jojo1193/Kicad-Library/README.md

# Kicad-Library
Own Kicad Library with different parts of different projects.
