jojo1193/Kicad-Library/Antenna/3d/ANT-433-USP410.step

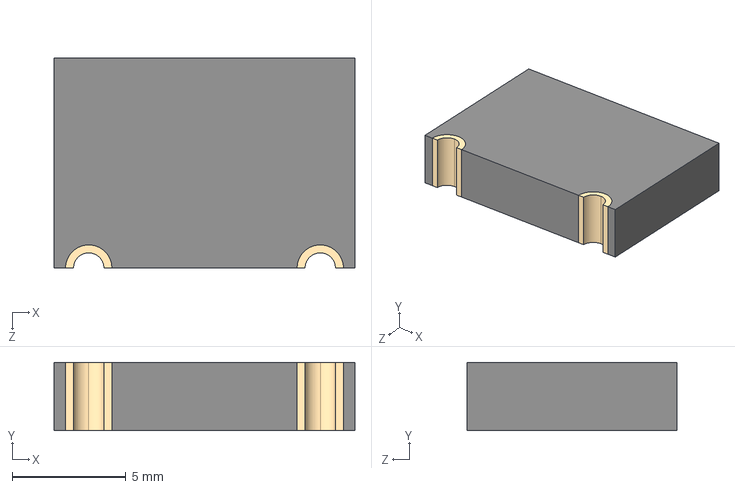
[picture p1: CAD file, 2024-01-16]
Antenna/3d/ANT-433-USP410.step
13.2 x 3.00 x 9.22 mm
