jojo1193/Kicad-Library/Caps/3d/AY1152M41Y5UC63L0.stp

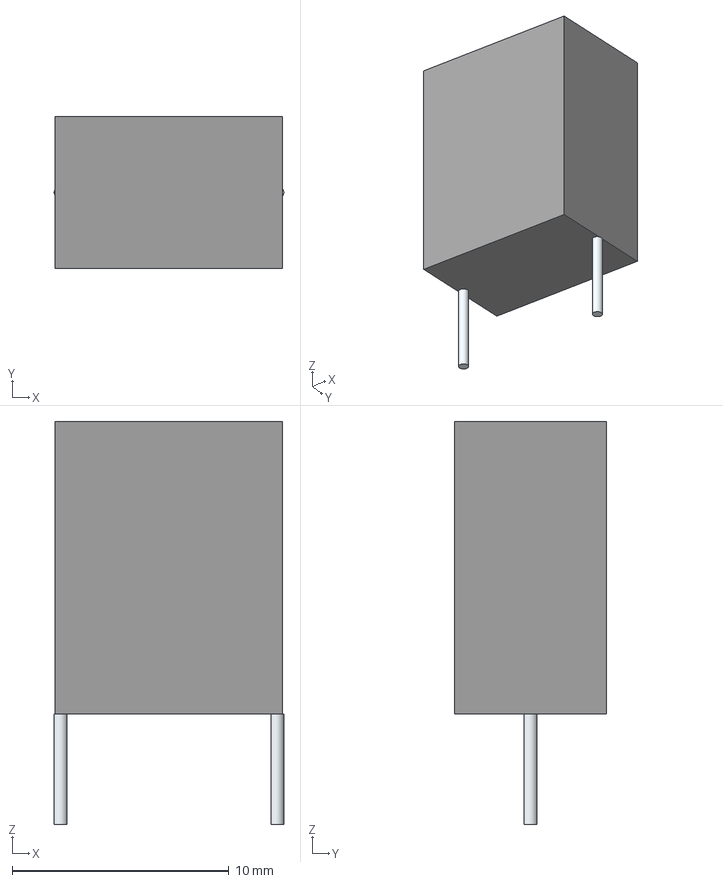
[picture p2: CAD file, 2024-01-16]
Caps/3d/AY1152M41Y5UC63L0.stp
10.6 x 7.00 x 18.6 mm
Leads
