jojo1193/Kicad-Library/Comparator/3d/TLV1811LDBVR.stp

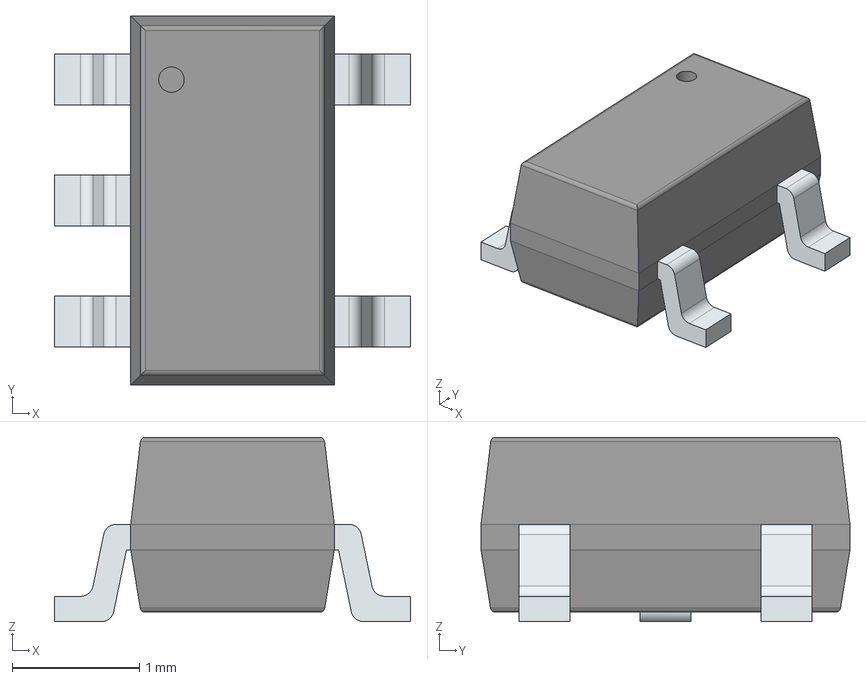
[picture p3: CAD file, 2024-11-26]
Comparator/3d/TLV1811LDBVR.stp
2.80 x 2.90 x 1.45 mm
PinsArrayL
PinsArrayR
