jojo1193/Kicad-Library/Connectors/3d/LD15S33E4GX00LF.stp

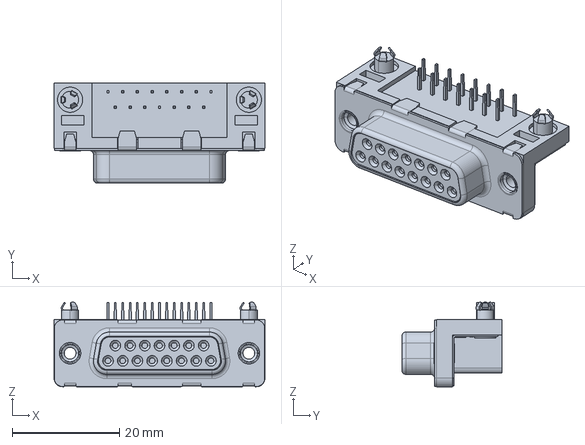
[picture p4: CAD file, 2024-11-26]
Connectors/3d/LD15S33E4GX00LF.stp
39.3 x 18.7 x 15.8 mm
