jojo1193/Kicad-Library/Crystal/3d/ECS-160-10-36-CKM-TR3.stp

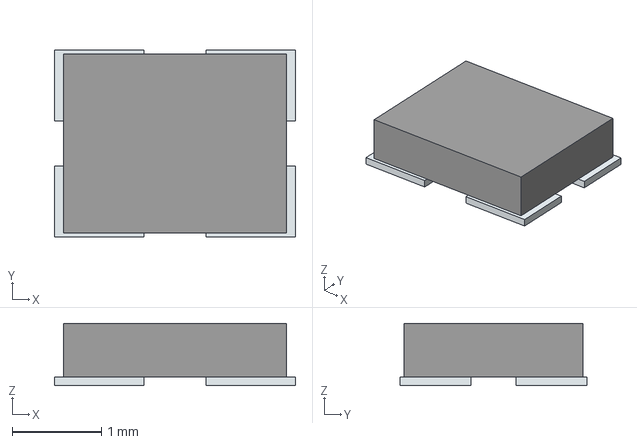
[picture p5: CAD file, 2024-01-16]
Crystal/3d/ECS-160-10-36-CKM-TR3.stp
2.70 x 2.10 x 0.7 mm
Pins
