jojo1193/Kicad-Library/Devices/3d/RX470C-V1 v6.step

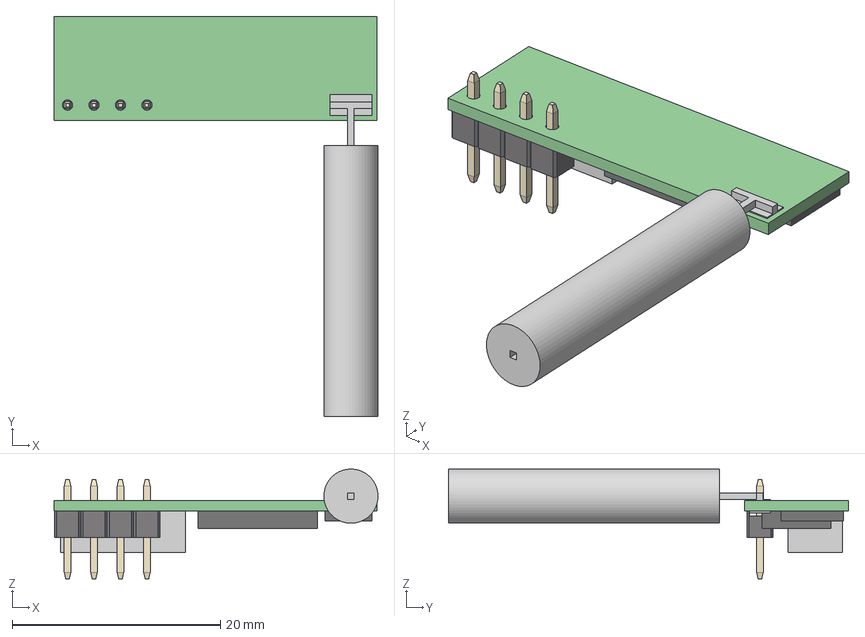
[picture p6: CAD file, 2024-01-16]
Devices/3d/RX470C-V1 v6.step
31.1 x 38.4 x 10.5 mm
BG030-04-A-0400-0300-N-G_P x 4
BG030-04-A-0400-0300-N-G_H
Platine
BauteilePlatine
Antenne
