jojo1193/Kicad-Library/Diode/3d/SL05.TCT.stp

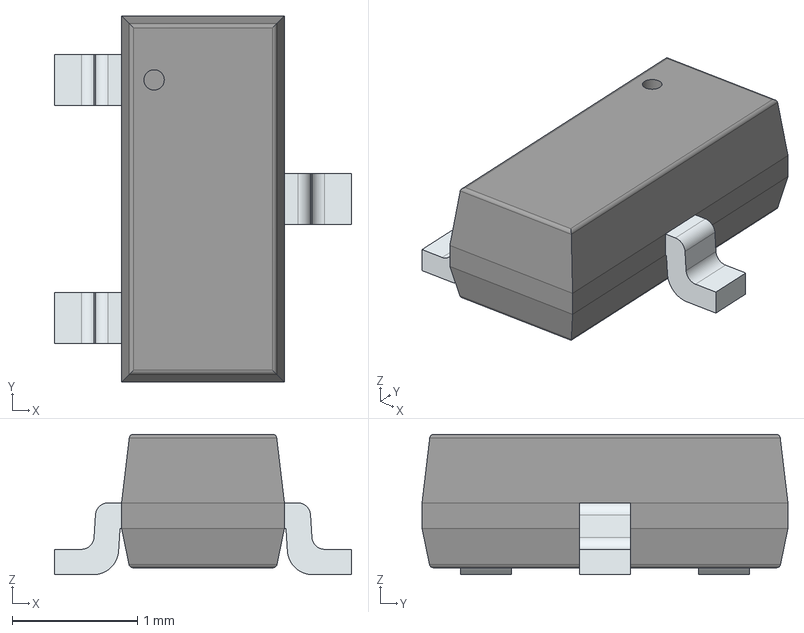
[picture p7: CAD file, 2024-11-26]
Diode/3d/SL05.TCT.stp
2.37 x 2.92 x 1.12 mm
PinsArrayL
FilletPinR
