jojo1193/Kicad-Library/IC/3d/AD587JRZ.stp

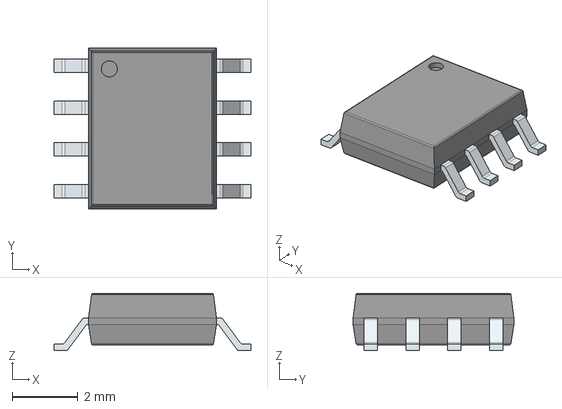
[picture p8: CAD file, 2024-01-16]
IC/3d/AD587JRZ.stp
6.00 x 4.90 x 1.75 mm
PinsArrayLR
