jojo1193/Kicad-Library/Inductors/3d/SSRH24NVS-35080.step

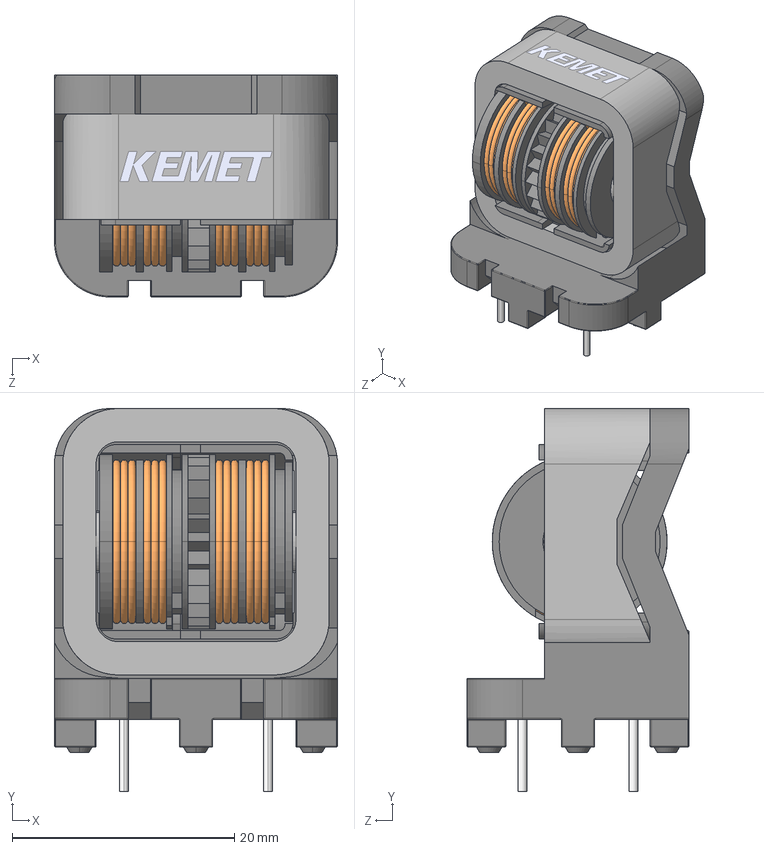
[picture p9: CAD file, 2024-11-29]
Inductors/3d/SSRH24NVS-35080.step
25.5 x 34.5 x 20.0 mm
