jojo1193/Kicad-Library/Logic/3d/NC7SZ32P5X-F22057.stp

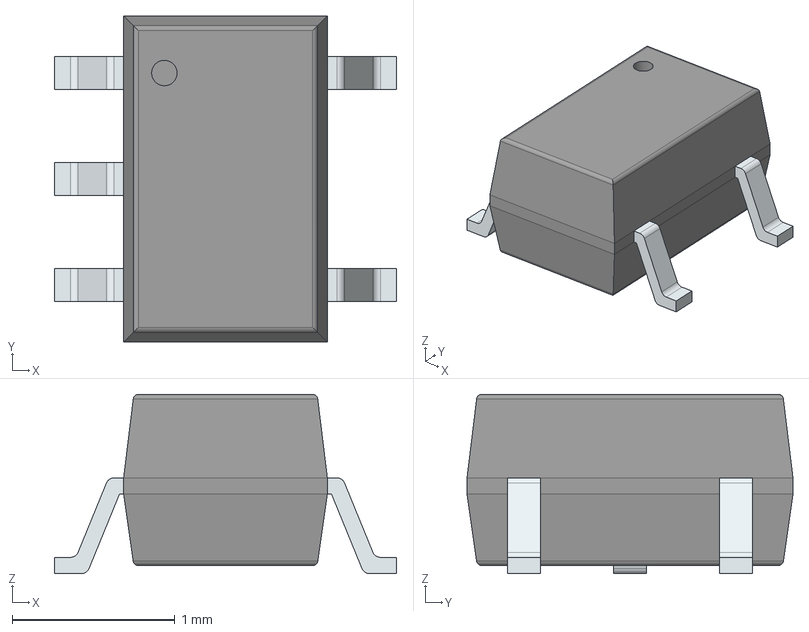
[picture p10: CAD file, 2024-01-16]
Logic/3d/NC7SZ32P5X-F22057.stp
2.10 x 2.00 x 1.10 mm
PinsArrayL
PinsArrayR
