jojo1193/Kicad-Library/Microcontroller/3d/STM32G030K6T6.stp

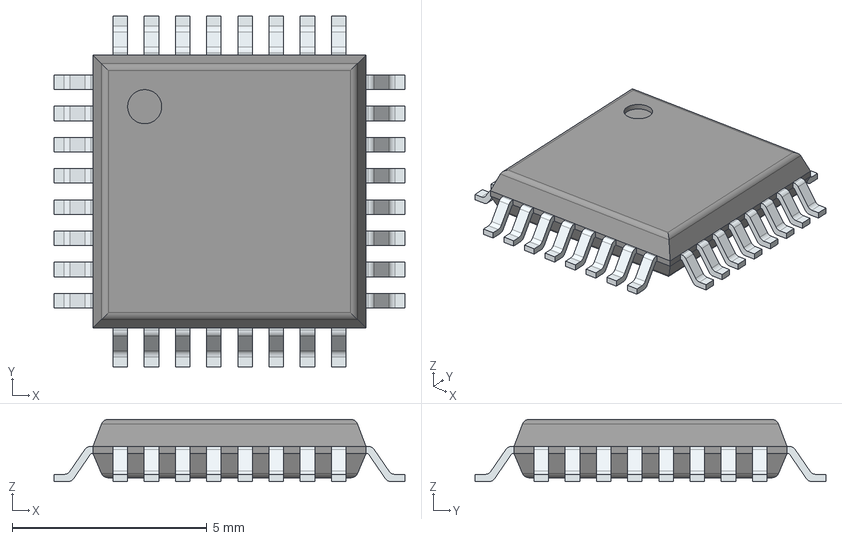
[picture p11: CAD file, 2024-03-09]
Microcontroller/3d/STM32G030K6T6.stp
9.00 x 9.00 x 1.60 mm
PinsArrayLR
PinsArrayTB
