jojo1193/Kicad-Library/MOSFET/3d/SSM3J132TU,LF.stp

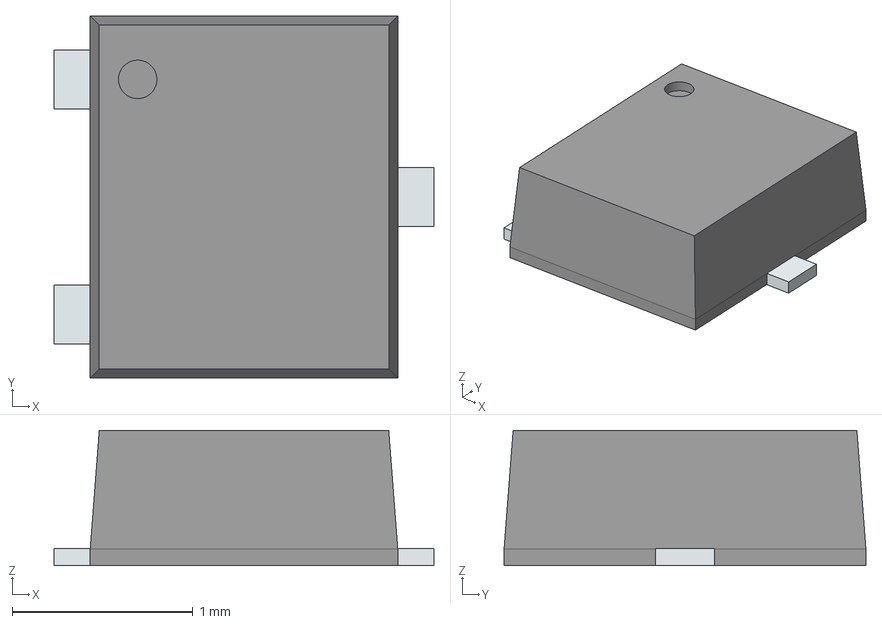
[picture p12: CAD file, 2024-07-02]
MOSFET/3d/SSM3J132TU,LF.stp
2.10 x 2.00 x 0.748 mm
PinsArrayL
PinsArrayR
