jojo1193/Kicad-Library/OpAmps/3d/NCV321SN3T1G.stp

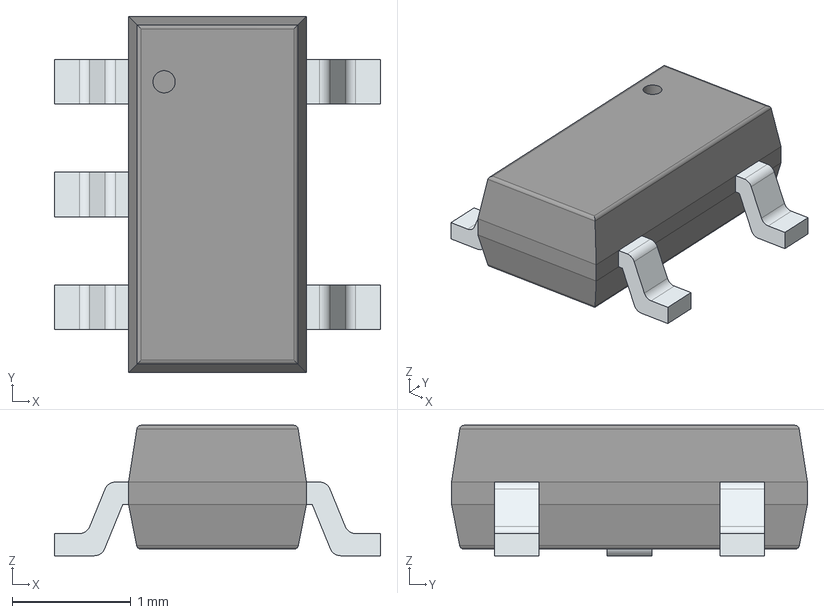
[picture p13: CAD file, 2024-01-16]
OpAmps/3d/NCV321SN3T1G.stp
2.75 x 3.00 x 1.10 mm
PinsArrayL
PinsArrayR
