jojo1193/Kicad-Library/Optocoupler/3d/OPI1280-032.STEP

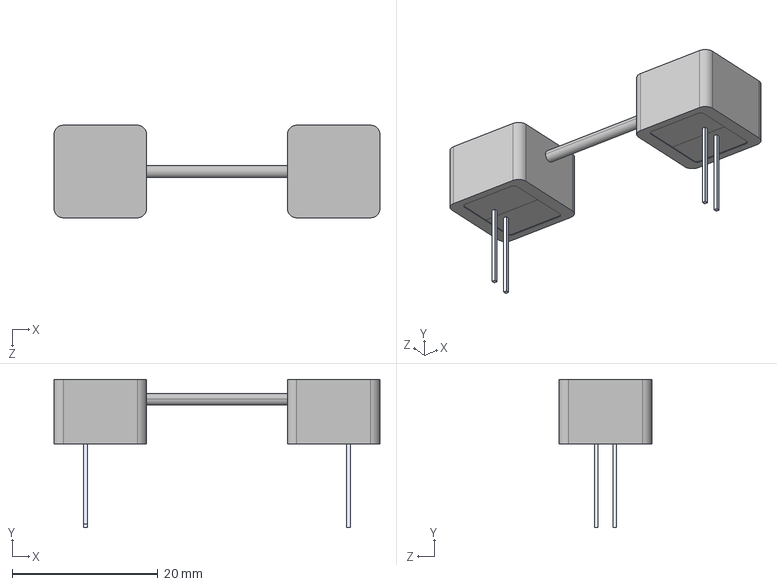
[picture p14: CAD file, 2024-01-16]
Optocoupler/3d/OPI1280-032.STEP
44.7 x 20.3 x 12.7 mm
