jojo1193/Kicad-Library/Regulators/3d/NCP1117ST50T3G.stp

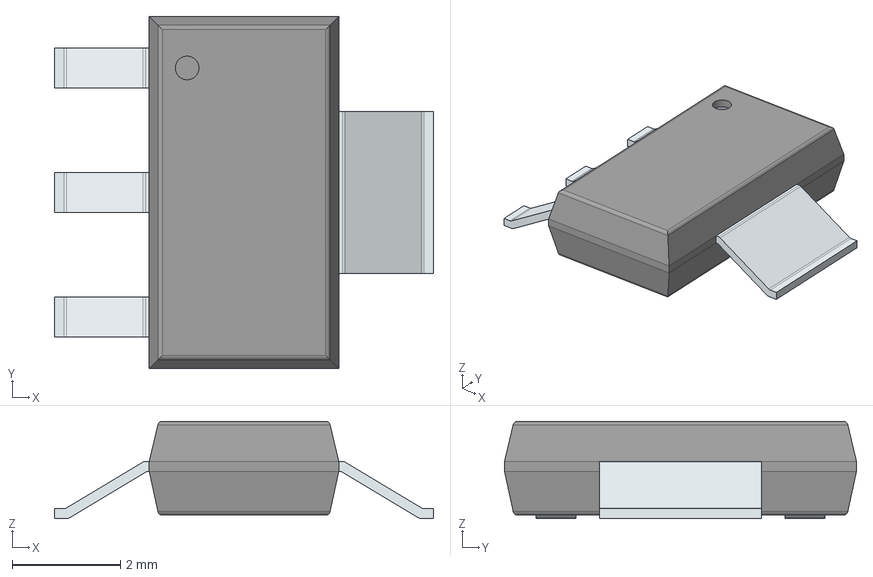
[picture p15: CAD file, 2024-01-16]
Regulators/3d/NCP1117ST50T3G.stp
7.00 x 6.50 x 1.80 mm
PinsArrayL
FilletPinR
