jojo1193/Kicad-Library/Resistor/3d/TC33X-2-103E.stp

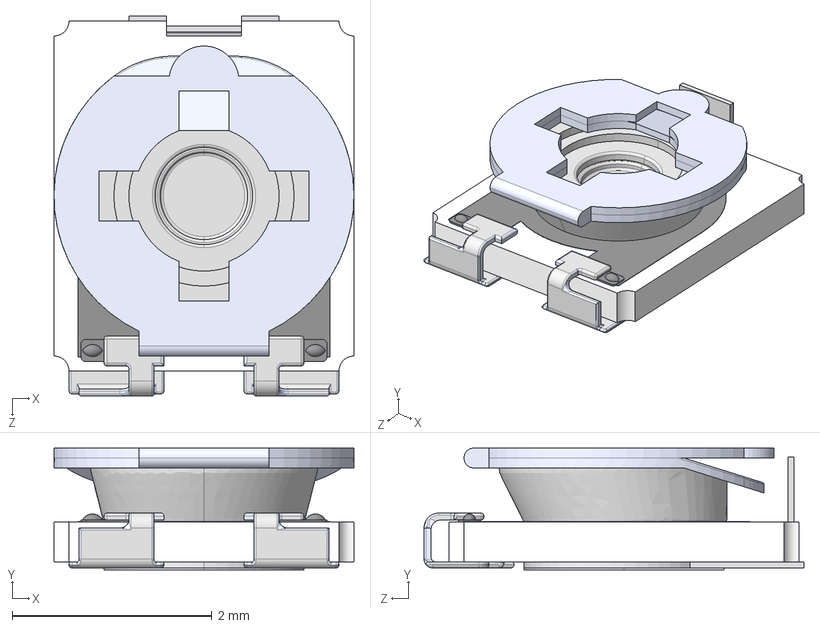
[picture p16: CAD file, 2024-01-16]
Resistor/3d/TC33X-2-103E.stp
3.00 x 1.22 x 3.80 mm
