jojo1193/Kicad-Library/Switch/3d/4-1825136-5.stp

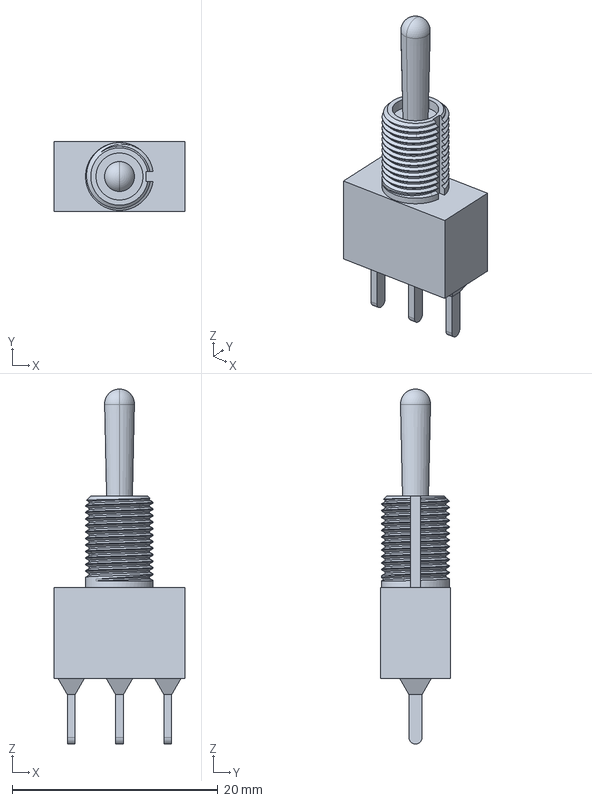
[picture p17: CAD file, 2024-11-29]
Switch/3d/4-1825136-5.stp
12.7 x 6.86 x 34.5 mm
