jojo1193/Kicad-Library/Testpoints/3d/Keystone Compact/Keystone-5005-Red.STEP

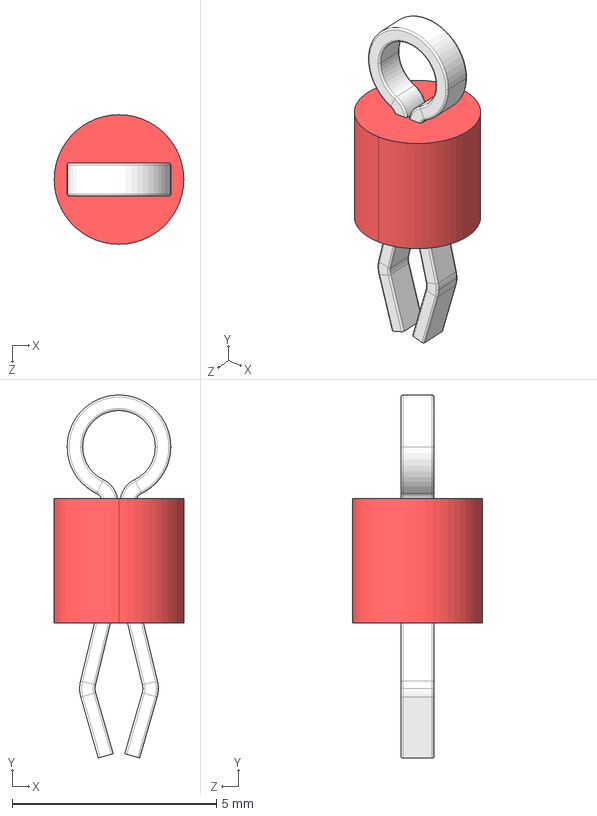
[picture p18: CAD file, 2024-11-26]
Testpoints/3d/Keystone Compact/Keystone-5005-Red.STEP
3.17 x 8.89 x 3.17 mm
