jojo1193/Kicad-Library/Testpoints/3d/Keystone Multipurpose/Keystone-PN5127-Blue.STEP

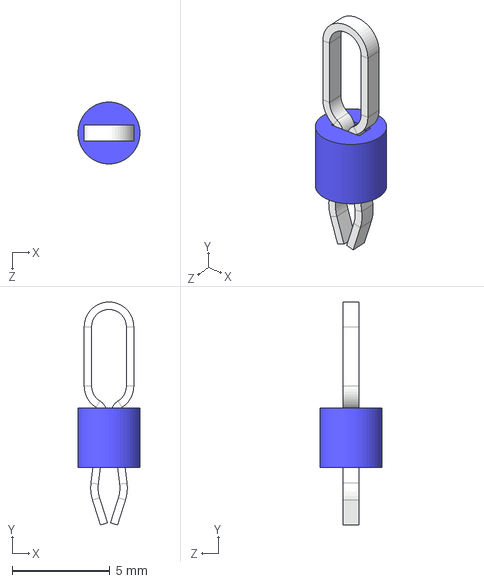
[picture p20: CAD file, 2024-11-26]
Testpoints/3d/Keystone Multipurpose/Keystone-PN5127-Blue.STEP
3.17 x 11.4 x 3.17 mm
