jojo1193/Kicad-Library/Wireless&HF_ICs/3d/CC113LRGPR.stp

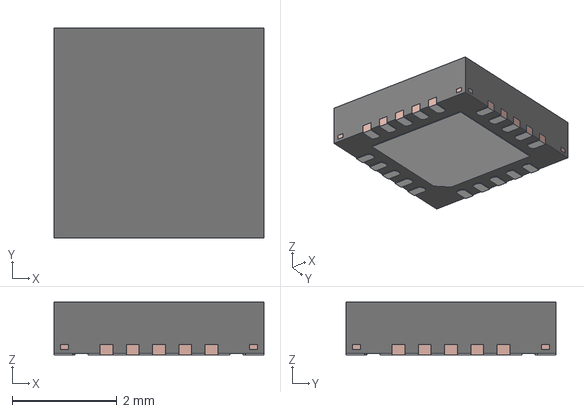
[picture p21: CAD file, 2024-07-02]
Wireless&HF_ICs/3d/CC113LRGPR.stp
4.00 x 4.00 x 1.00 mm
FRAME
