jojo1193/Kicad-Library/Caps/3d/CP_D8mmH12.2mm.stp

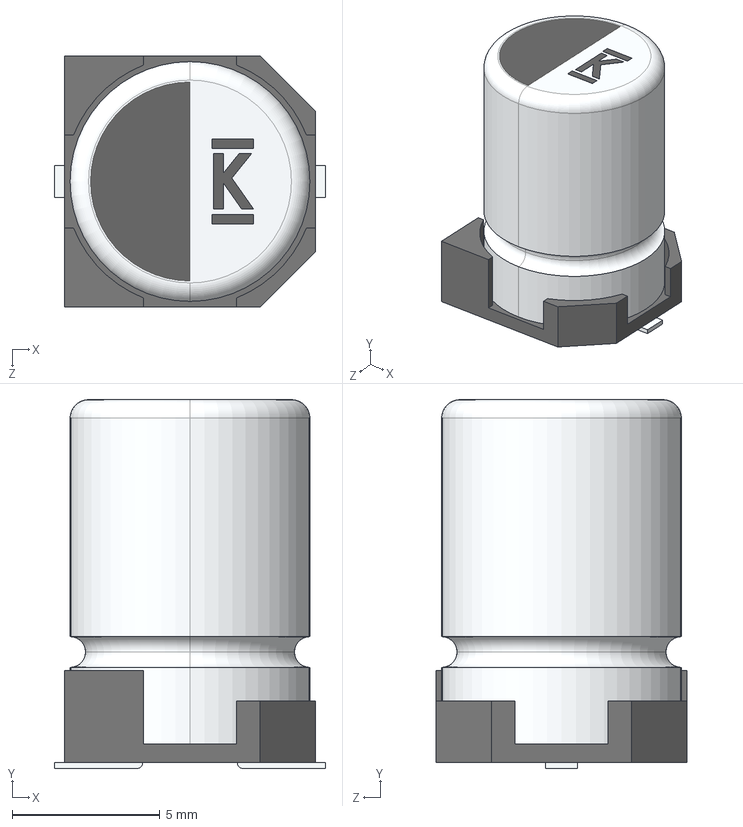
[picture p22: CAD file, 2024-01-16]
Caps/3d/CP_D8mmH12.2mm.stp
9.20 x 12.5 x 8.50 mm
