jojo1193/Kicad-Library/Connectors/3d/MicroUSB.stp

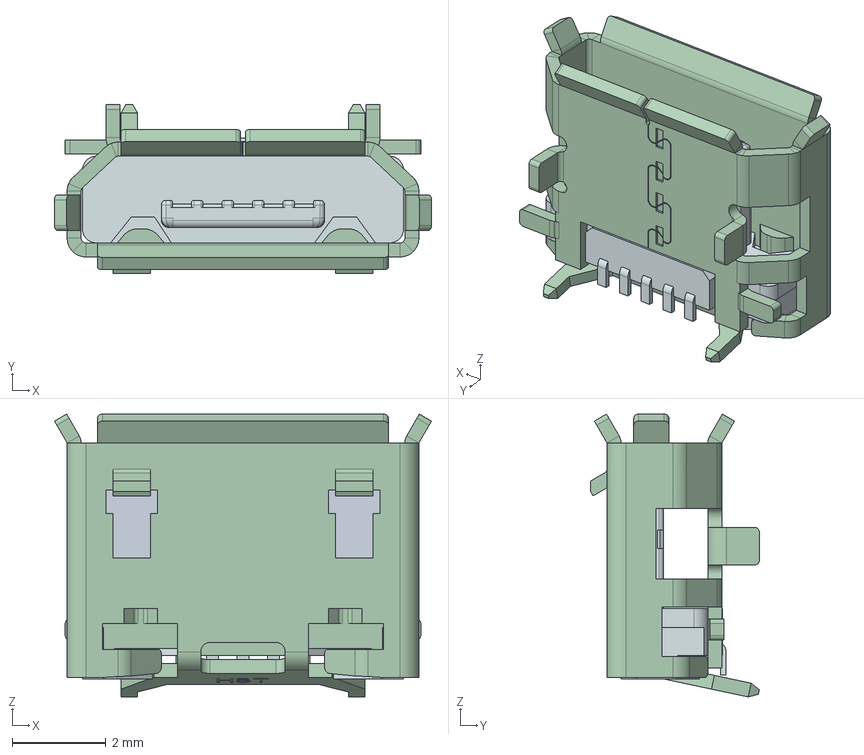
[picture p23: CAD file, 2024-07-02]
Connectors/3d/MicroUSB.stp
8.04 x 3.60 x 6.03 mm
