jojo1193/Kicad-Library/DCDCconverter/3d/AE15-EW-S12.stp

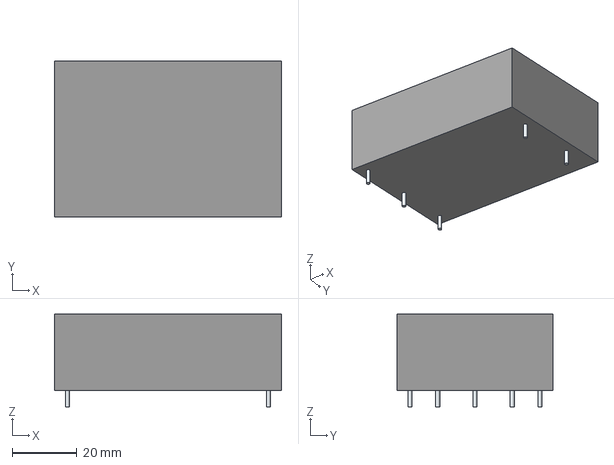
[picture p24: CAD file, 2024-01-16]
DCDCconverter/3d/AE15-EW-S12.stp
70.0 x 48.0 x 28.6 mm
Leads
