jojo1193/Kicad-Library/Inductors/3d/FBMH2016HM121NT.stp

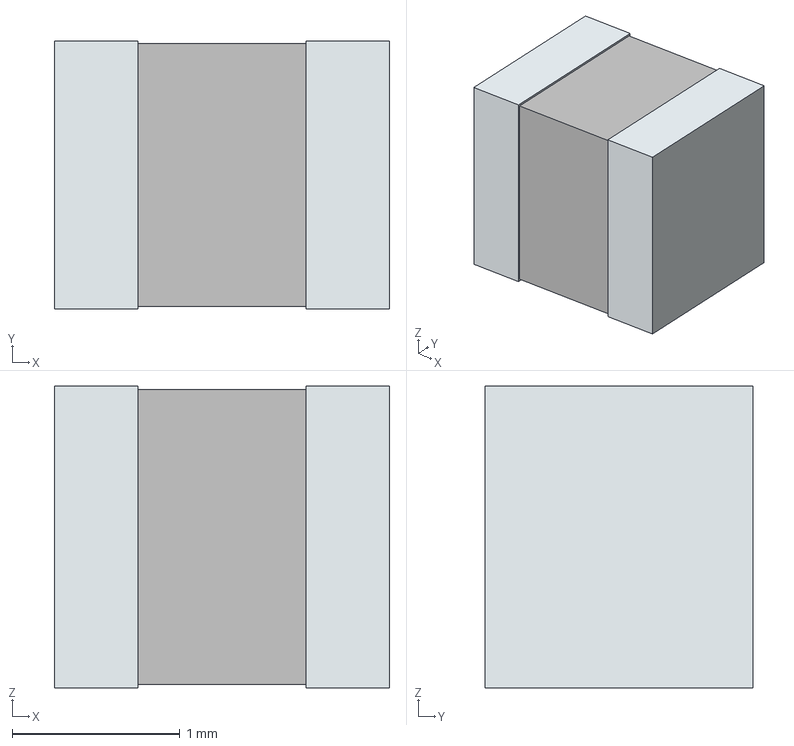
[picture p25: CAD file, 2024-07-02]
Inductors/3d/FBMH2016HM121NT.stp
2.00 x 1.60 x 1.80 mm
term1
term2
