jojo1193/Kicad-Library/OpAmps/3d/TS372CDT.stp

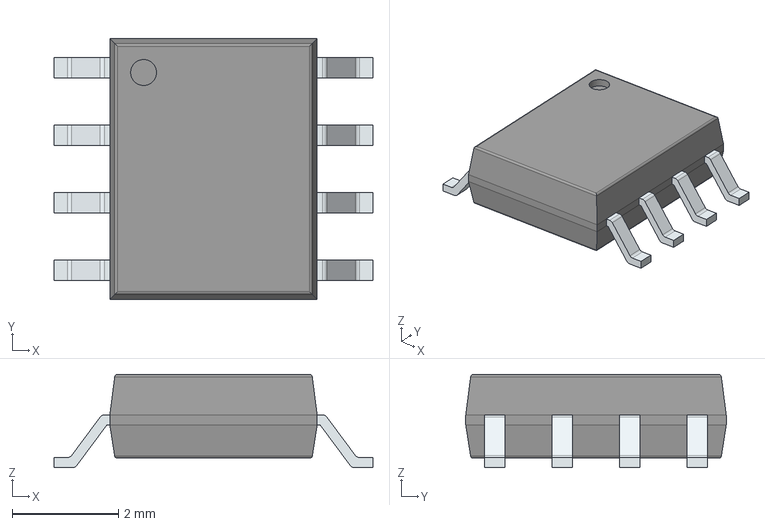
[picture p26: CAD file, 2024-01-16]
OpAmps/3d/TS372CDT.stp
6.00 x 4.90 x 1.75 mm
PinsArrayLR
