jojo1193/Kicad-Library/Regulators/3d/BAJ2CC0FP-E2.stp

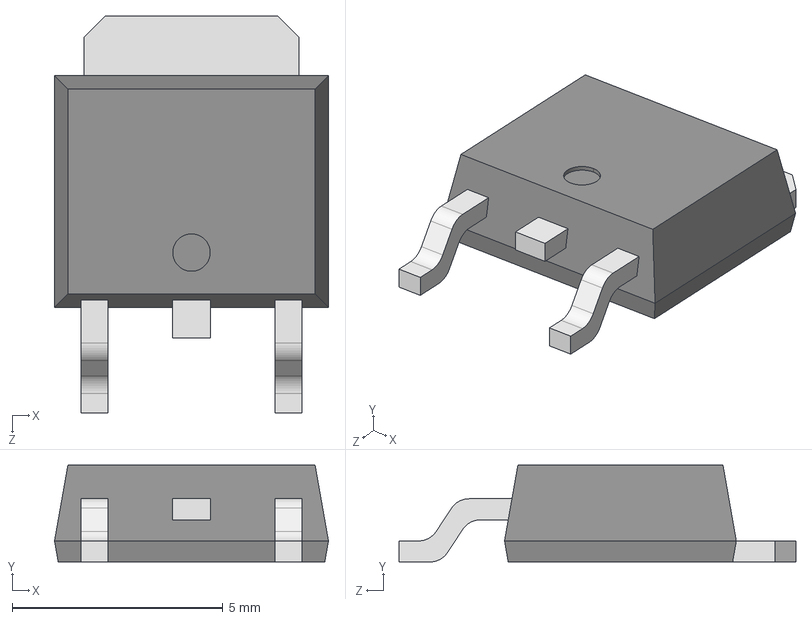
[picture p27: CAD file, 2024-01-16]
Regulators/3d/BAJ2CC0FP-E2.stp
6.50 x 2.30 x 9.41 mm
