jojo1193/Kicad-Library/Switch/3d/09.03290.01.stp

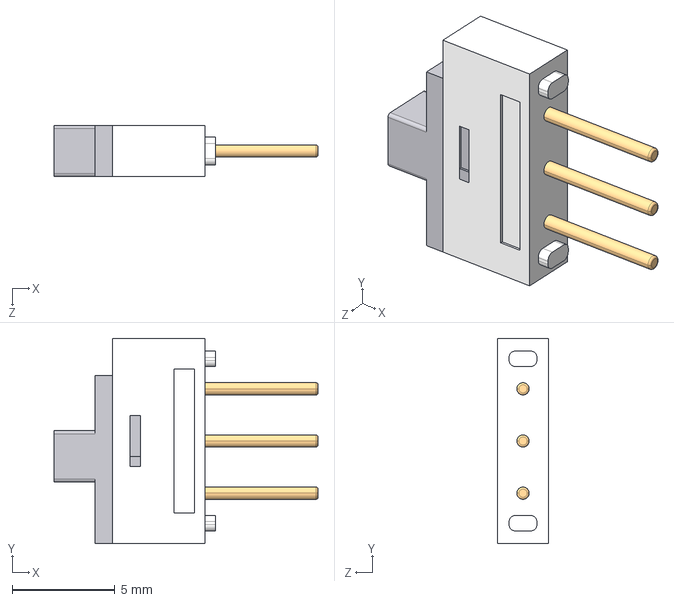
[picture p28: CAD file, 2024-11-26]
Switch/3d/09.03290.01.stp
12.8 x 10.0 x 2.50 mm
