jojo1193/Kicad-Library/Testpoints/3d/Keystone Compact/Keystone-5121-Green.STEP

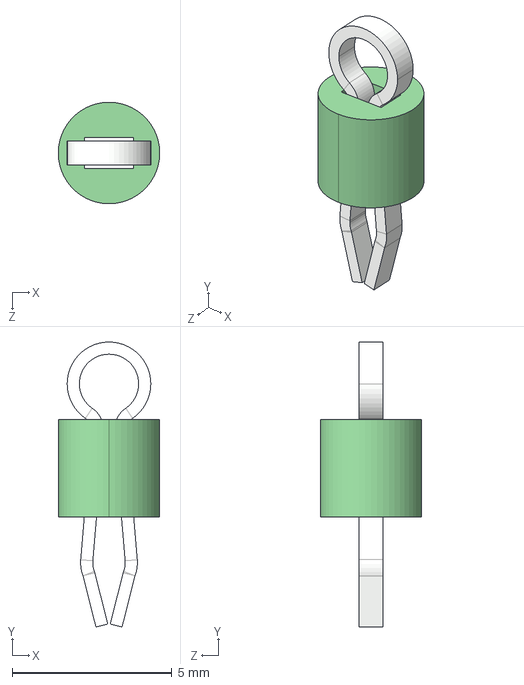
[picture p29: CAD file, 2024-11-26]
Testpoints/3d/Keystone Compact/Keystone-5121-Green.STEP
3.18 x 8.92 x 3.18 mm
