jojo1193/Kicad-Library/Caps/3d/C2220C226M5R2CAUTO.stp

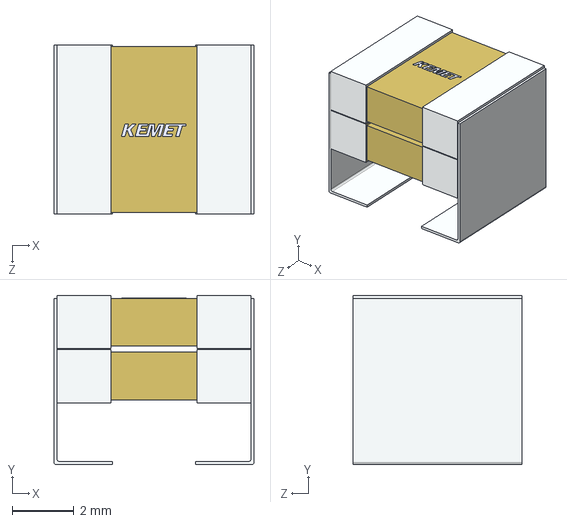
[picture p30: CAD file, 2024-01-16]
Caps/3d/C2220C226M5R2CAUTO.stp
6.50 x 5.50 x 5.50 mm
