jojo1193/Kicad-Library/Connectors/3d/StifleisteHeader2_54_1row4pos.stp

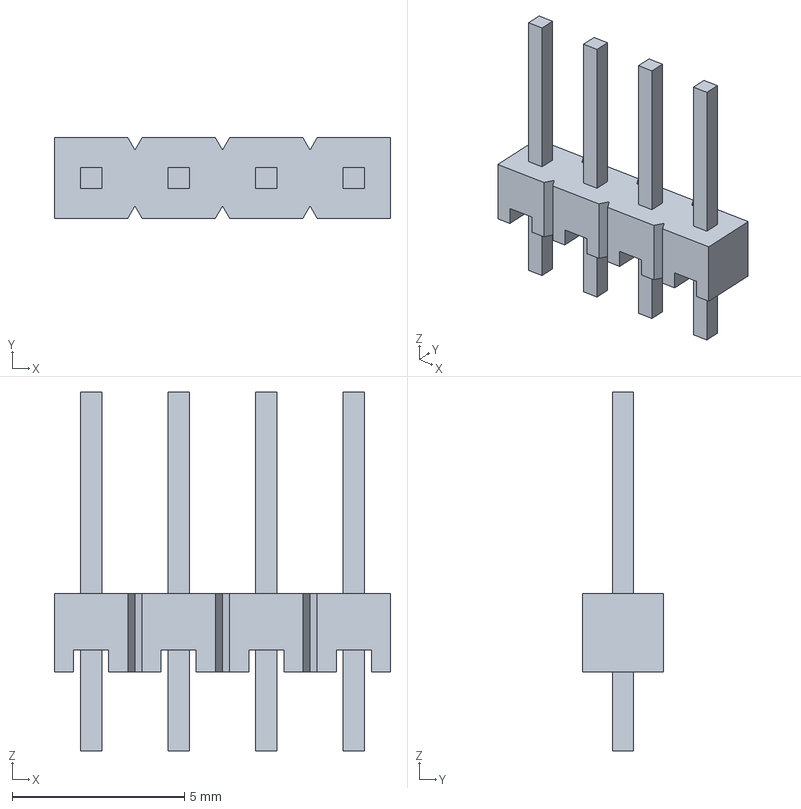
[picture p31: CAD file, 2024-01-16]
Connectors/3d/StifleisteHeader2_54_1row4pos.stp
9.75 x 2.34 x 10.4 mm
