jojo1193/Kicad-Library/DCDCconverter/3d/TRI_10-1213.stp

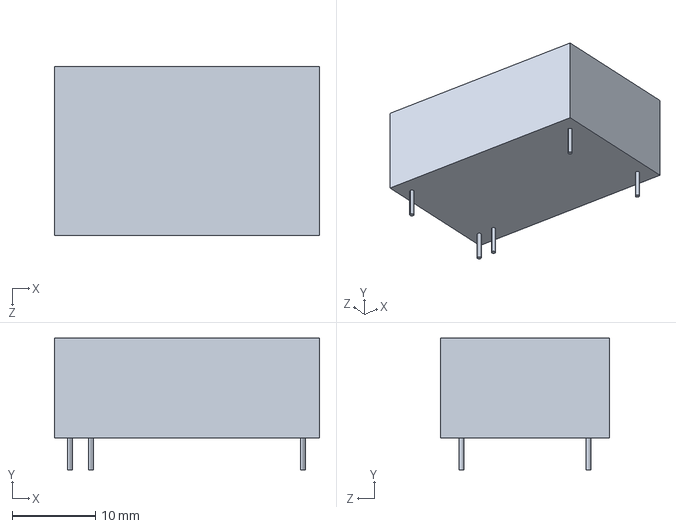
[picture p32: CAD file, 2024-01-16]
DCDCconverter/3d/TRI_10-1213.stp
31.8 x 15.8 x 20.3 mm
