jojo1193/Kicad-Library/Diode/3d/SZSMF4L5.0AT3G.stp

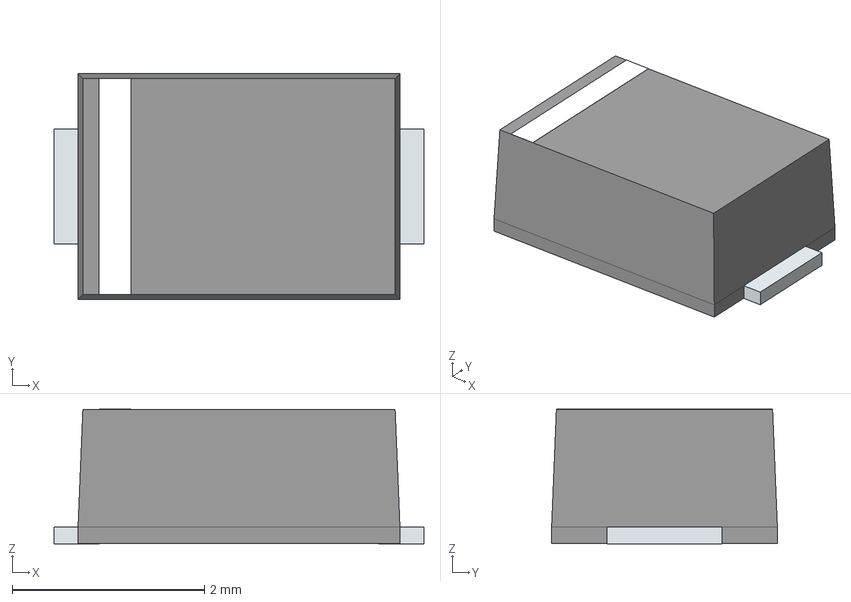
[picture p33: CAD file, 2024-07-02]
Diode/3d/SZSMF4L5.0AT3G.stp
3.85 x 2.35 x 1.40 mm
PinKIdent
PinK
PinA
