jojo1193/Kicad-Library/Inductors/3d/VLCF4028T-2R2N1R9-2.stp

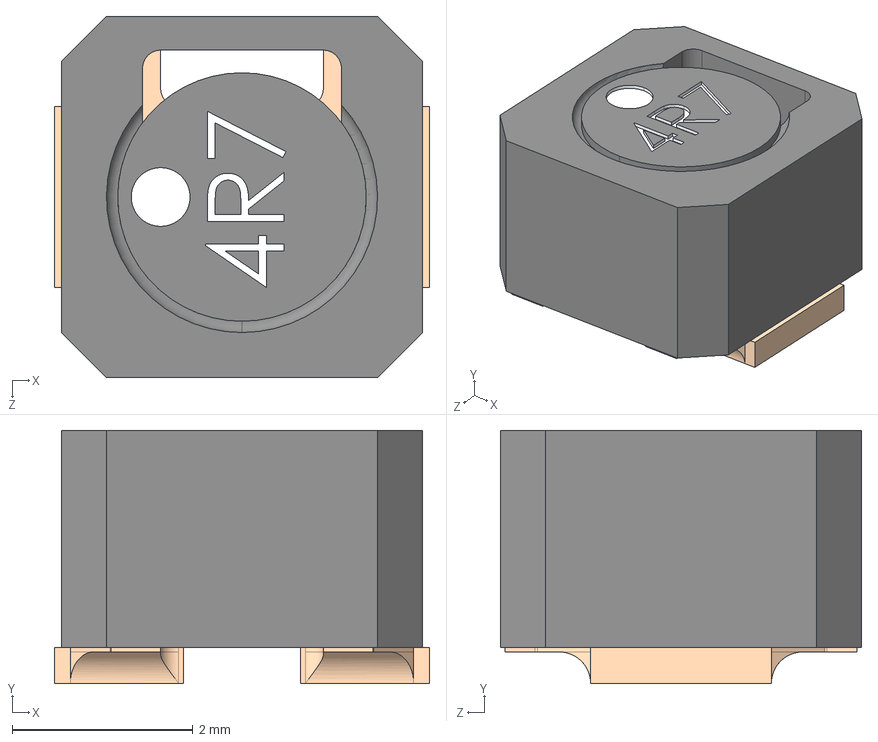
[picture p34: CAD file, 2024-03-10]
Inductors/3d/VLCF4028T-2R2N1R9-2.stp
4.15 x 2.80 x 4.00 mm
