jojo1193/Kicad-Library/Logic/3d/BU4S81G2-TR.stp

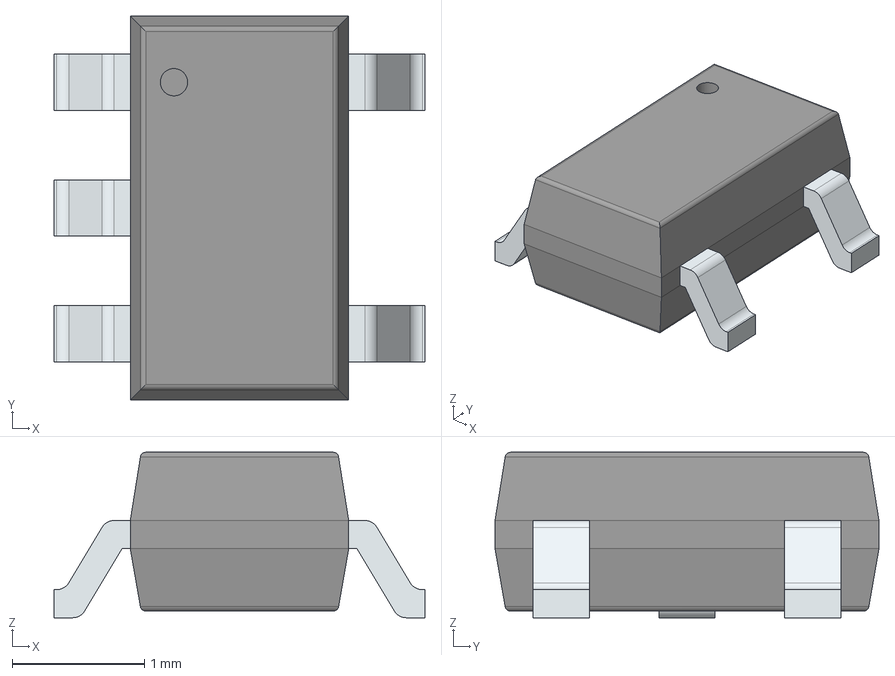
[picture p35: CAD file, 2024-01-16]
Logic/3d/BU4S81G2-TR.stp
2.80 x 2.90 x 1.25 mm
PinsArrayL
PinsArrayR
