jojo1193/Kicad-Library/Regulators/3d/MIC5271YM5-TR.stp

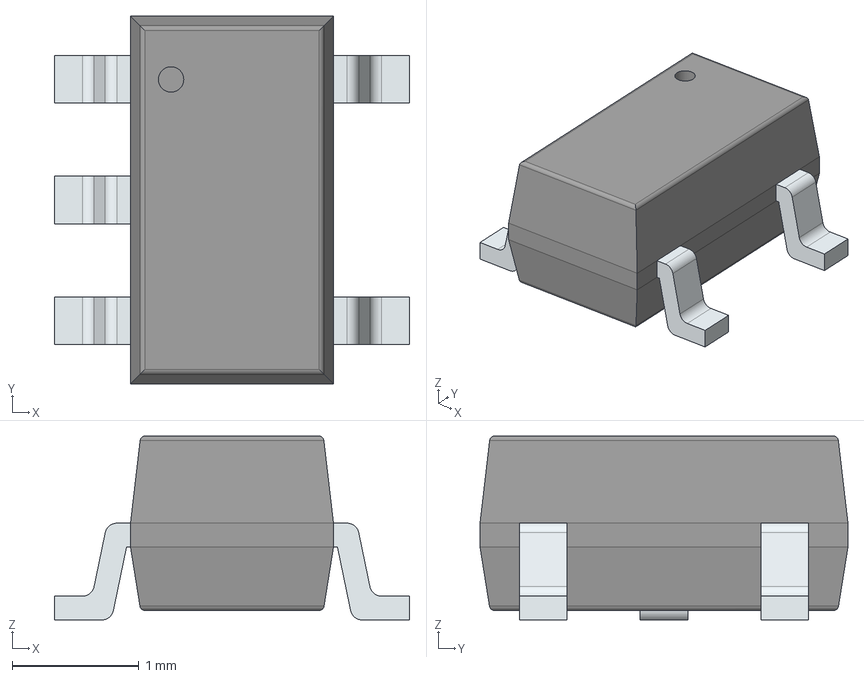
[picture p36: CAD file, 2024-01-16]
Regulators/3d/MIC5271YM5-TR.stp
2.80 x 2.90 x 1.45 mm
PinsArrayL
PinsArrayR
