jojo1193/Kicad-Library/Switch/3d/Wurth_Electronics_-_430152070826.stp

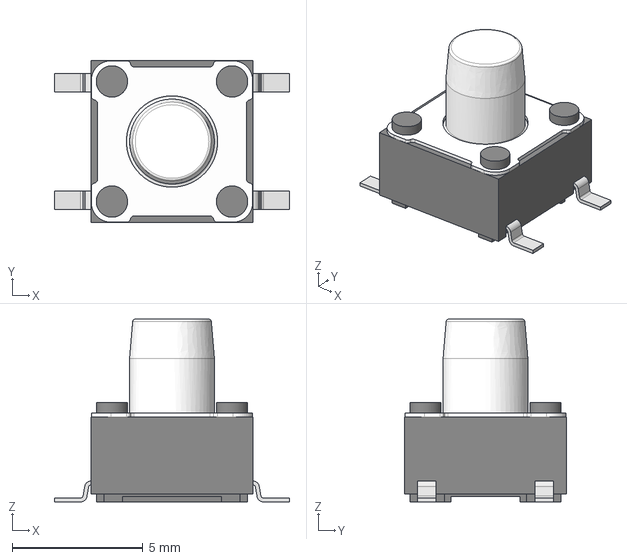
[picture p37: CAD file, 2024-01-16]
Switch/3d/Wurth_Electronics_-_430152070826.stp
9.00 x 6.20 x 7.00 mm
