jojo1193/Kicad-Library/SwitchingVoltageRegulator/3d/LM2682MM_NOPB.stp

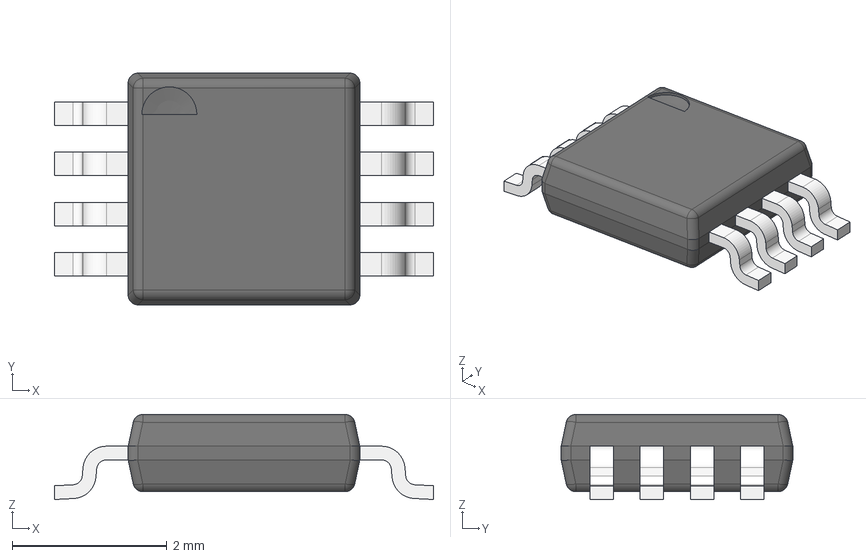
[picture p38: CAD file, 2024-01-16]
SwitchingVoltageRegulator/3d/LM2682MM_NOPB.stp
4.90 x 3.00 x 1.10 mm
BODY_MUA08A
LEAD_MUA08A x 8
