jojo1193/Kicad-Library/Testpoints/3d/Keystone Miniature/5116.stp

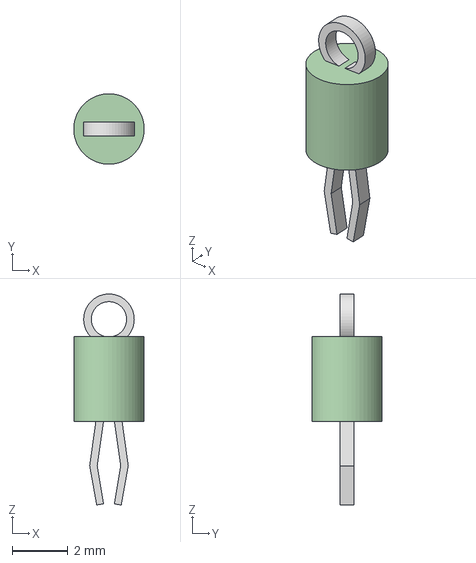
[picture p39: CAD file, 2024-11-26]
Testpoints/3d/Keystone Miniature/5116.stp
2.54 x 2.54 x 7.60 mm
