jojo1193/Kicad-Library/Testpoints/3d/Keystone Multipurpose/Keystone-PN5011-Black.STEP

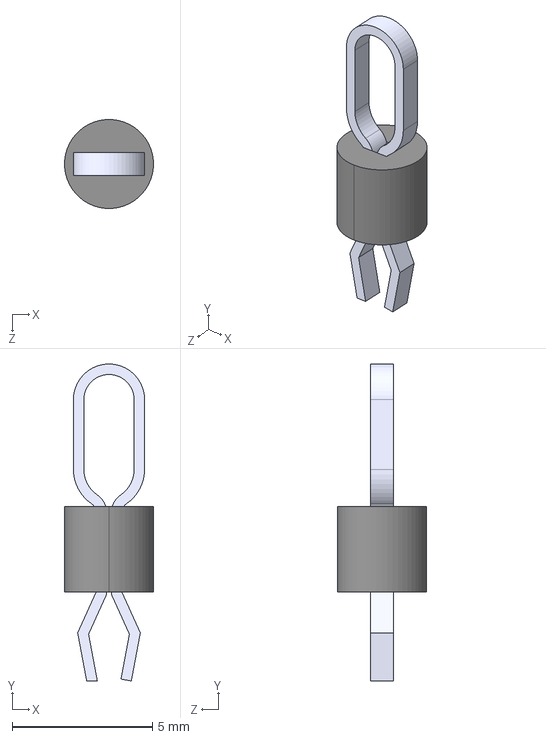
[picture p40: CAD file, 2024-11-26]
Testpoints/3d/Keystone Multipurpose/Keystone-PN5011-Black.STEP
3.17 x 11.3 x 3.17 mm
