jojo1193/Kicad-Library/Caps/3d/EKXJ401ELL470ML20S.stp

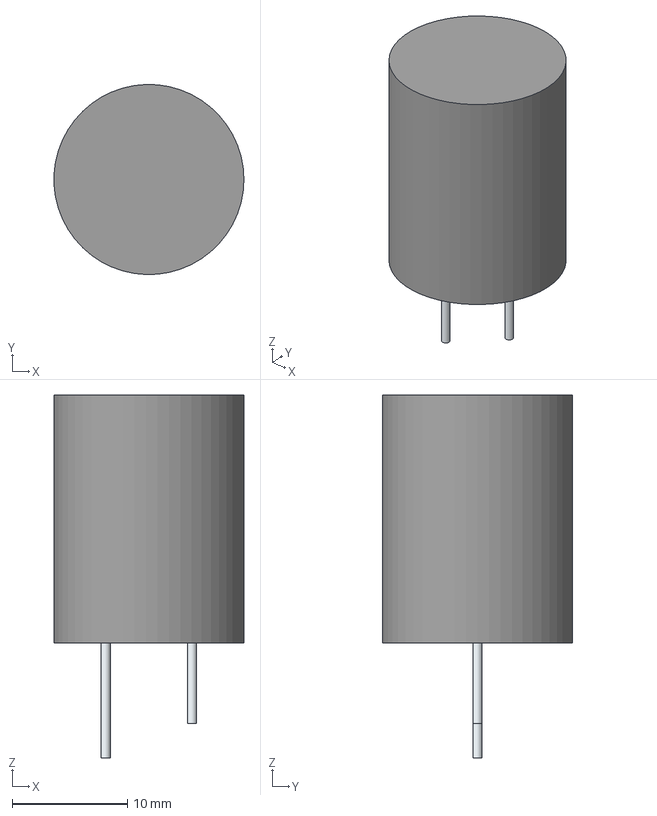
[picture p41: CAD file, 2024-01-16]
Caps/3d/EKXJ401ELL470ML20S.stp
16.5 x 16.5 x 31.5 mm
SimpleBody
Pin1
Pin2
