jojo1193/Kicad-Library/Connectors/3d/66.9040-21.stp

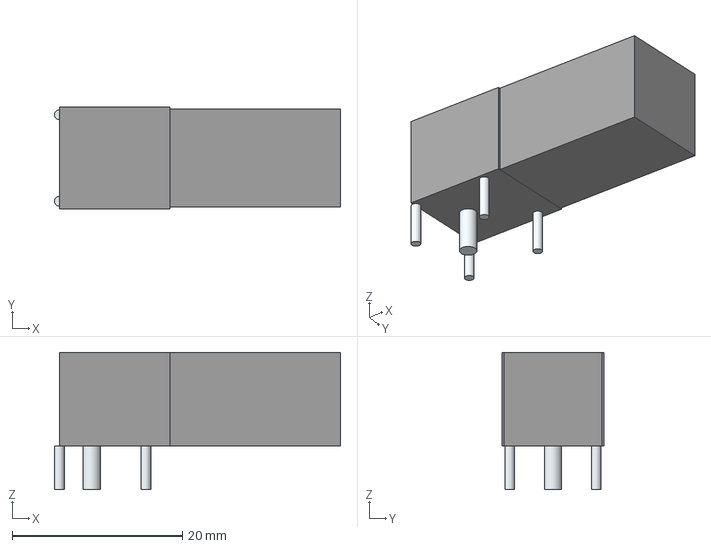
[picture p42: CAD file, 2024-01-16]
Connectors/3d/66.9040-21.stp
33.6 x 12.0 x 16.1 mm
Leads x 5
