jojo1193/Kicad-Library/Diode/3d/DO-221AD-2.step

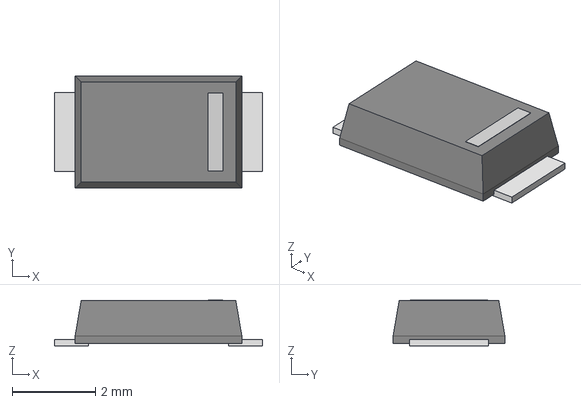
[picture p43: CAD file, 2024-01-16]
Diode/3d/DO-221AD-2.step
5.00 x 2.69 x 1.10 mm
