jojo1193/Kicad-Library/Regulators/3d/BDJ0FC0WEFJ-E2.stp

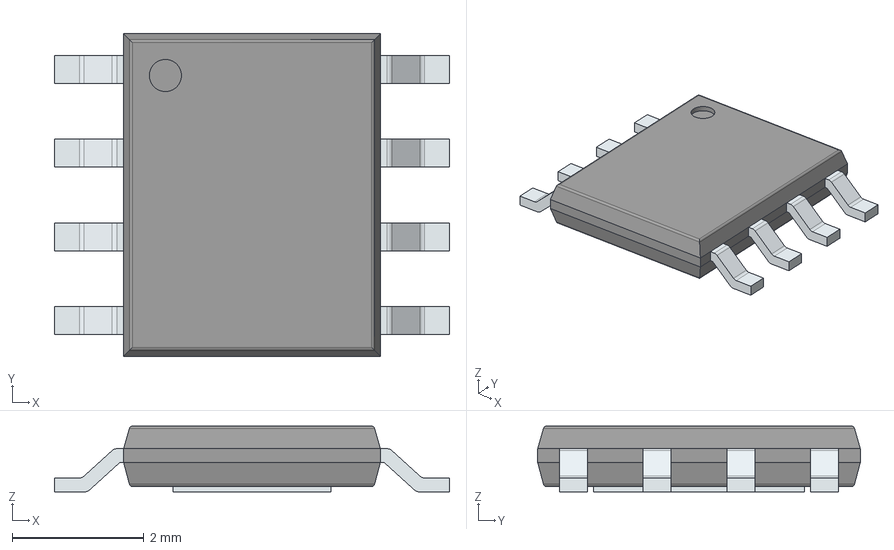
[picture p44: CAD file, 2024-01-16]
Regulators/3d/BDJ0FC0WEFJ-E2.stp
6.00 x 4.90 x 1.00 mm
PinsArrayLR
ThermalPad
