jojo1193/Kicad-Library/Switch/3d/HEV2AN-P-DC12V.stp

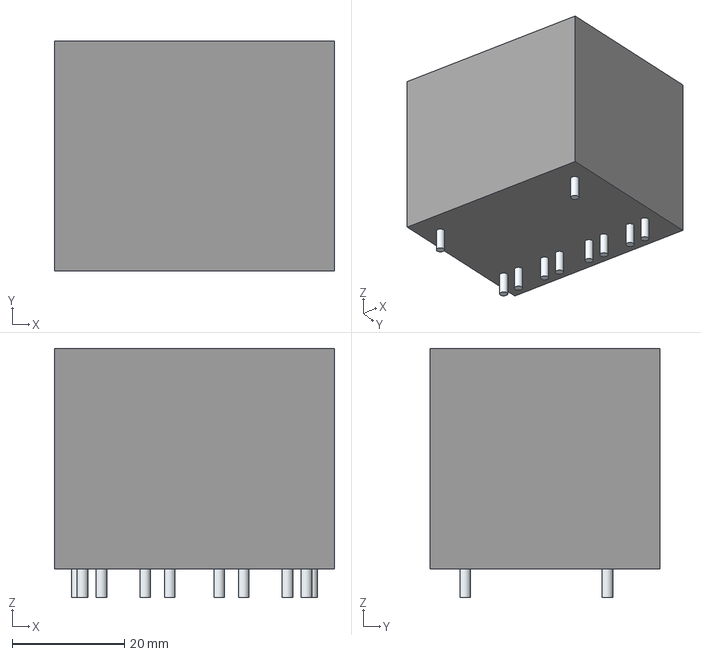
[picture p45: CAD file, 2024-01-16]
Switch/3d/HEV2AN-P-DC12V.stp
50.0 x 41.0 x 44.5 mm
Leads
