jojo1193/Kicad-Library/Testpoints/3d/Keystone Miniature/5115.stp

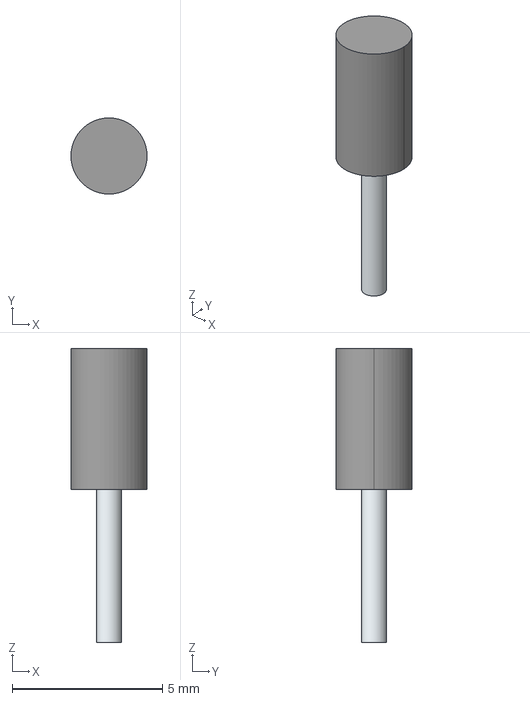
[picture p46: CAD file, 2024-11-26]
Testpoints/3d/Keystone Miniature/5115.stp
2.54 x 2.54 x 9.80 mm
Leads
