jojo1193/Kicad-Library/Testpoints/3d/Keystone Miniature/5117.stp

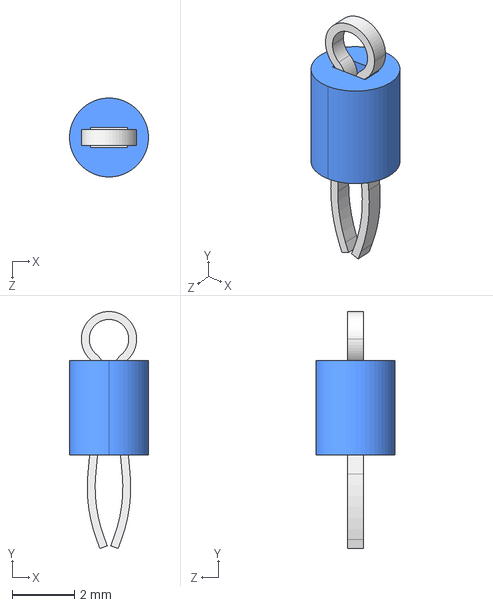
[picture p47: CAD file, 2024-11-26]
Testpoints/3d/Keystone Miniature/5117.stp
2.54 x 7.62 x 2.54 mm
