jojo1193/Kicad-Library/Connectors/3d/5-104935-7.stp

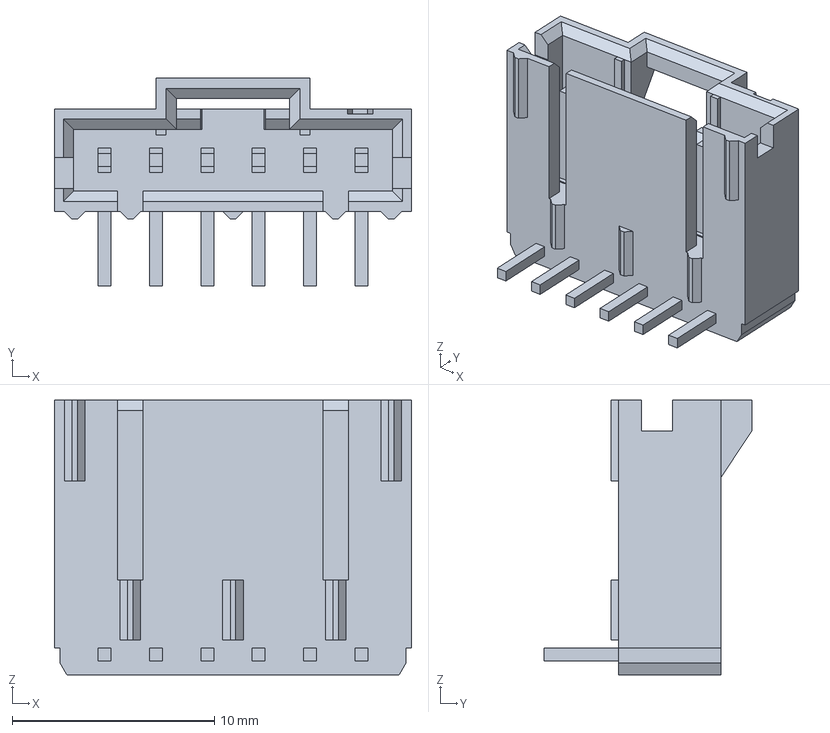
[picture p48: CAD file, 2024-01-16]
Connectors/3d/5-104935-7.stp
17.6 x 10.3 x 13.6 mm
