jojo1193/Kicad-Library/Inductors/3d/SCF29XV-070-1R2A030JV.stp

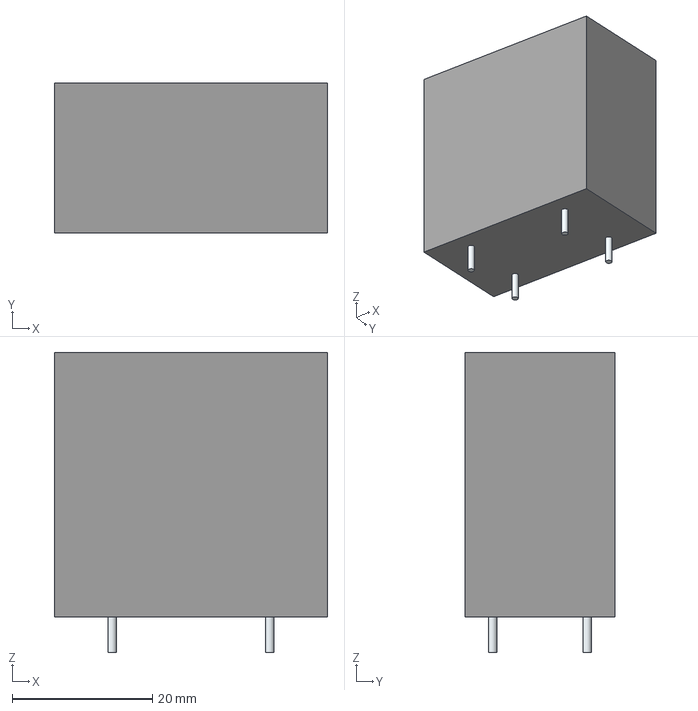
[picture p49: CAD file, 2024-01-16]
Inductors/3d/SCF29XV-070-1R2A030JV.stp
39.0 x 21.4 x 42.8 mm
Leads
