jojo1193/Kicad-Library/Connectors/3d/236-402_334-604.stp

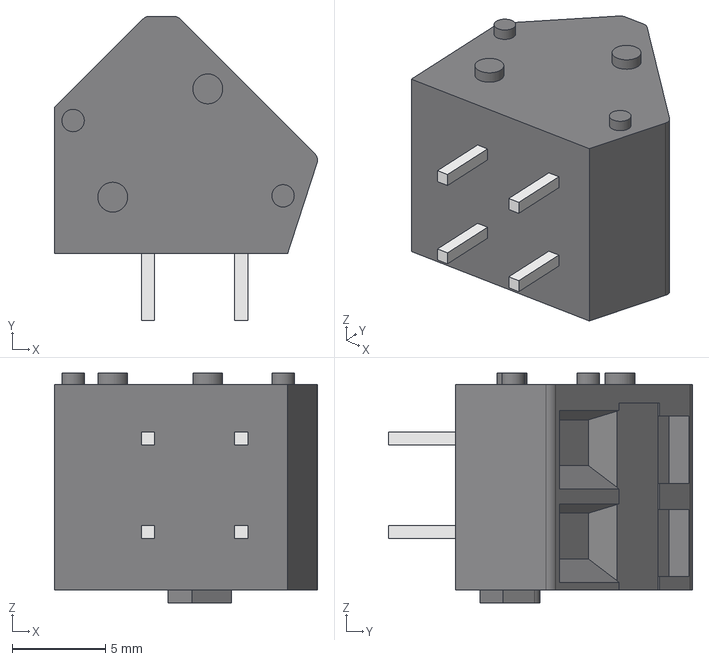
[picture p50: CAD file, 2024-01-16]
Connectors/3d/236-402_334-604.stp
14.1 x 16.3 x 12.3 mm
