jojo1193/Kicad-Library/Inductors/3d/2828 (7373 metric).stp

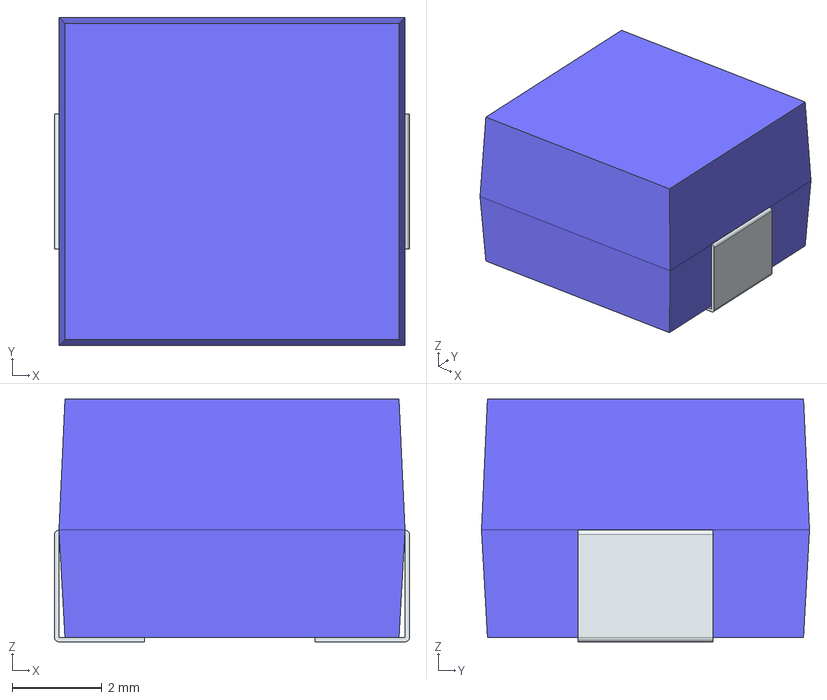
[picture p51: CAD file, 2024-01-16]
Inductors/3d/2828 (7373 metric).stp
7.90 x 7.30 x 5.40 mm
FilletPin1
FilletPin2
