jojo1193/Kicad-Library/Inductors/3d/SC-04-E50J.stp

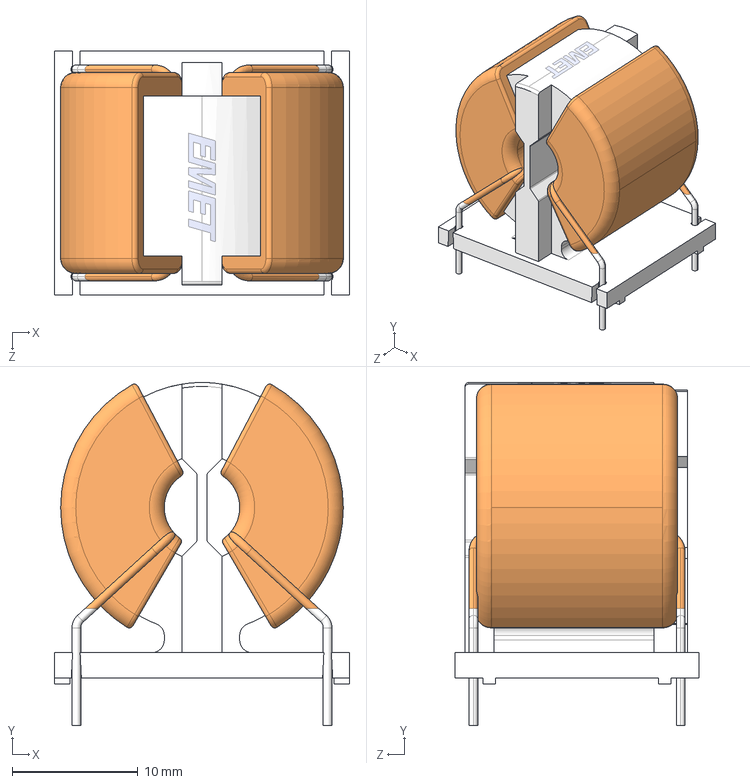
[picture p52: CAD file, 2024-01-16]
Inductors/3d/SC-04-E50J.stp
23.5 x 27.3 x 19.4 mm
