jojo1193/Kicad-Library/(list of files, cad)

Other CAD files:
Testpoints/3d/Keystone Multipurpose/Keystone-PN5129-Purple.step
Testpoints/3d/Keystone Compact/Keystone-5122-Blue.STEP
Testpoints/3d/Keystone Multipurpose/Keystone-PN5126-Green.STEP
Testpoints/3d/Keystone Multipurpose/Keystone-PN5010-Red.STEP
Regulators/3d/SOT353_TSOP-5.stp
Connectors/3d/74650195R.stp
DCDCconverter/3d/UCC28740DR.stp
Diode/3d/150080M153000.step
Inductors/3d/7448014501.stp
Inductors/3d/B82724J8482N040.stp
Inductors/3d/S14100038.stp
Logic/3d/MC14043BDR2G.stp
Regulators/3d/TPS72301DBVTG4.stp
SwitchingVoltageRegulator/3d/TPS54202DDCT.stp
SwitchingVoltageRegulator/3d/TPS562242DRLR.stp
Wireless&HF_ICs/3d/MAX41473GTC+.stp
