jojo1193/Kicad-Library/(commit log)

2024-01-16 Added existing librarys
    [236-402_334-604.stp, 2828 (7373 metric).stp, 5-104935-7.stp, 66.9040-21.stp, 7448014501.stp, 74650195R.stp, AD587JRZ.stp, AE15-EW-S12.stp]
2024-03-10 new components
    [TPS562242DRLR.stp, VLCF4028T-2R2N1R9-2.stp]
2024-07-02 Update
    Update
    [150080M153000.step, CC113LRGPR.stp, FBMH2016HM121NT.stp, MicroUSB.stp, SSM3J132TU,LF.stp, SZSMF4L5.0AT3G.stp]
2024-11-20 Added parts
    [TPS54202DDCT.stp, TRI_10-1213.stp]
2024-11-26 Testpoints added
    [09.03290.01.stp, Keystone-5005-Red.STEP, Keystone-5121-Green.STEP, Keystone-5122-Blue.STEP, Keystone-PN5010-Red.STEP, Keystone-PN5011-Black.STEP, Keystone-PN5126-Green.STEP, Keystone-PN5127-Blue.STEP]
