jojo1193/Kicad-Library/(notices)

Notices in the files:
Connectors/3d/236-402_334-604.stp:
author */ ('License CC BY-ND 4.0'),
